moeritsen2/pypilot_obp/pics/IMG_2758.jpg

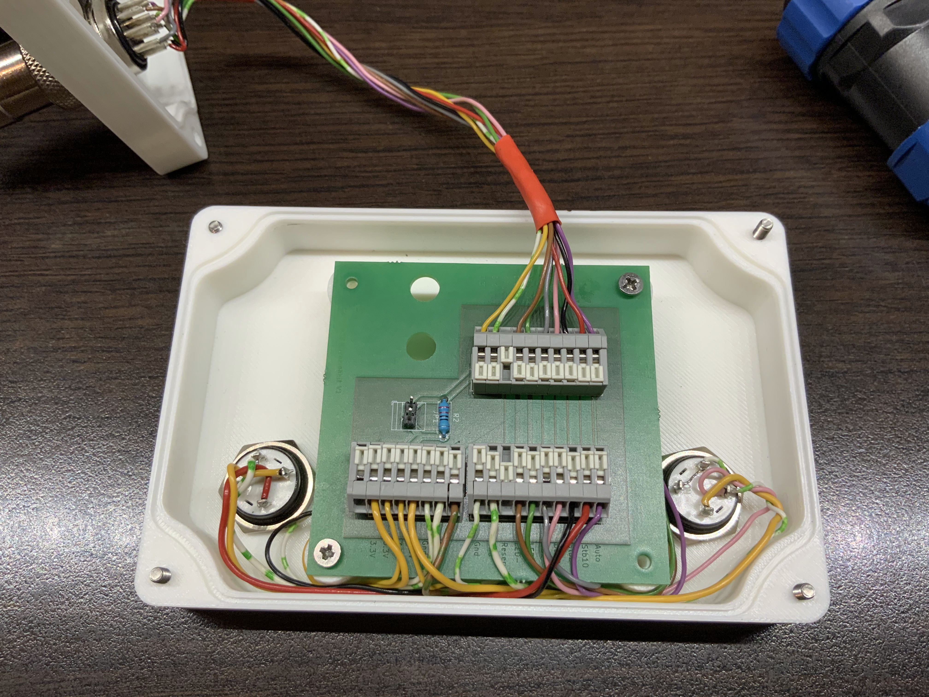
pics/IMG_2758.jpg
