moeritsen2/pypilot_obp/data/Übersicht Pypilot 2025.pdf

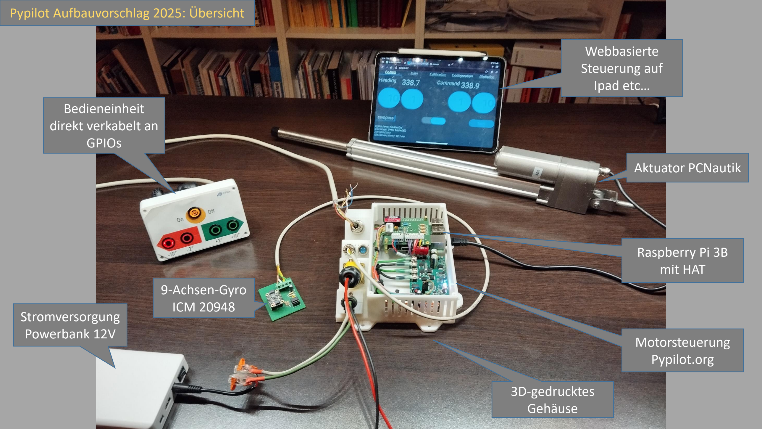
[picture p3: page 1]

Stromversorgung
Powerbank 12V

Bedieneinheit
direkt verkabelt an
GPIOs

9-Achsen-Gyro
ICM 20948

Motorsteuerung
Pypilot.org

Raspberry Pi 3B
mit HAT

Aktuator PCNautik

Webbasierte
Steuerung auf
Ipad etc…

3D-gedrucktes
Gehäuse

Pypilot Aufbauvorschlag 2025: Übersicht

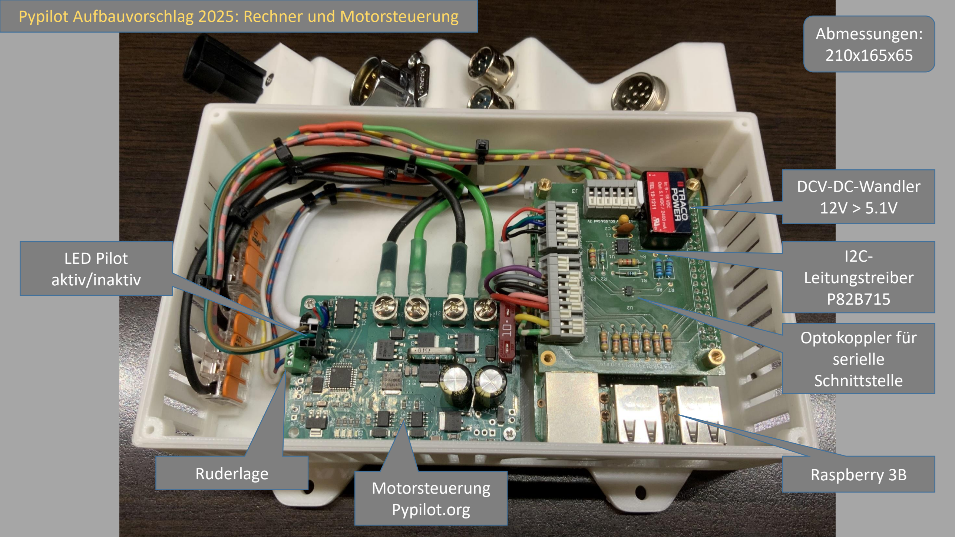
[picture p4: page 2]

Motorsteuerung
Pypilot.org

Ruderlage

DCV-DC-Wandler
12V > 5.1V

LED Pilot
aktiv/inaktiv

I2C-Leitungstreiber
P82B715

Optokoppler für
serielle
Schnittstelle

Raspberry 3B

Pypilot Aufbauvorschlag 2025: Rechner und Motorsteuerung Abmessungen:
210x165x65

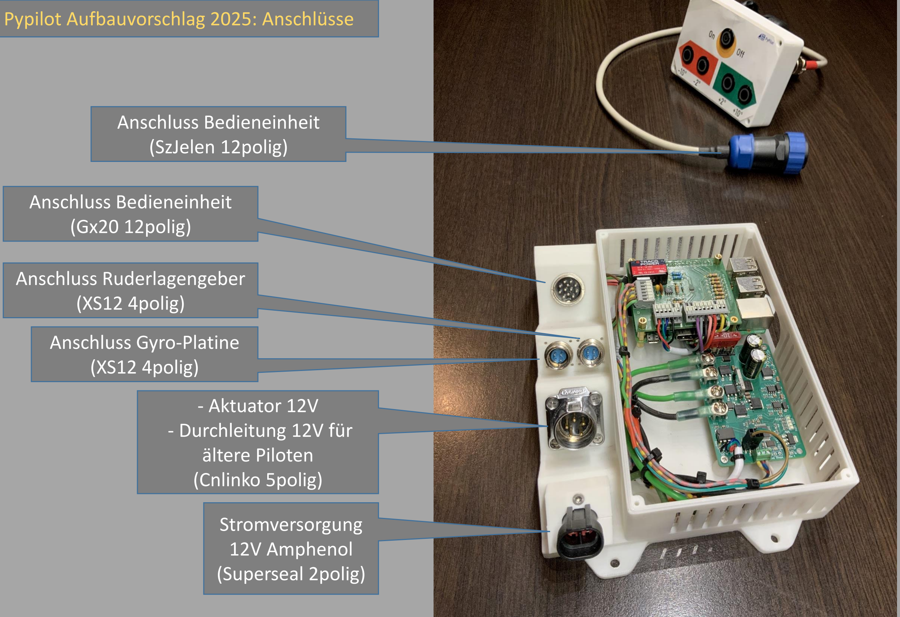
[picture p5: figure]
Pypilot Aufbauvorschlag 2025: Anschlüsse; Stromversorgung 12V Amphenol (Superseal 2polig); - Aktuator 12V - Durchleitung 12V für ältere Piloten (Cnlinko 5polig); Anschluss Gyro-Platine (XS12 4polig); Anschluss Ruderlagengeber (XS12 4polig); Anschluss Bedieneinheit (Gx20 12polig); Anschluss Bedieneinheit (SzJelen 12polig)
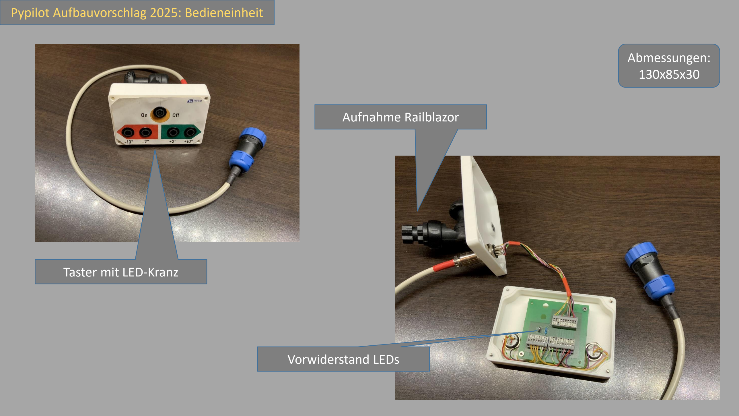
[picture p6: page 4]

Taster mit LED-Kranz

Aufnahme Railblazor

Vorwiderstand LEDs

Pypilot Aufbauvorschlag 2025: Bedieneinheit

Abmessungen:
130x85x30
