moeritsen2/pypilot_obp/AndroidASOP_DL.pdf

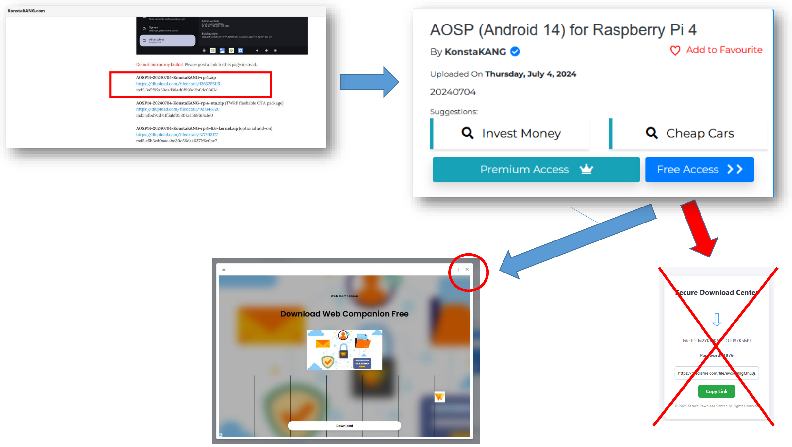
[picture p7: page 1]
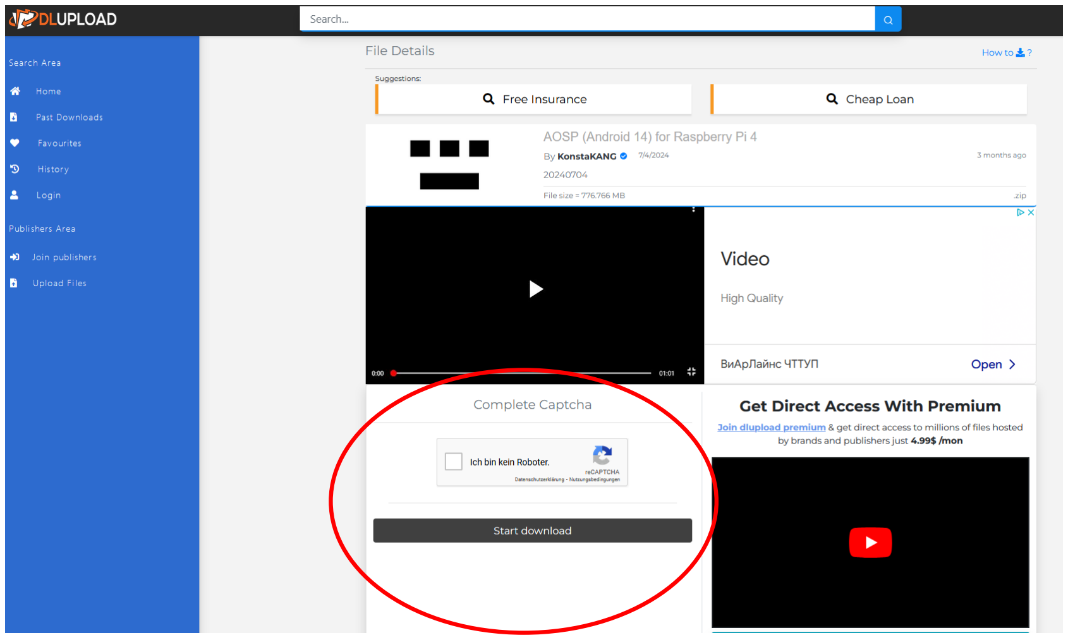
[picture p8: page 2]
