moeritsen2/pypilot_obp/boards/PlatineBedieneinheit.pdf

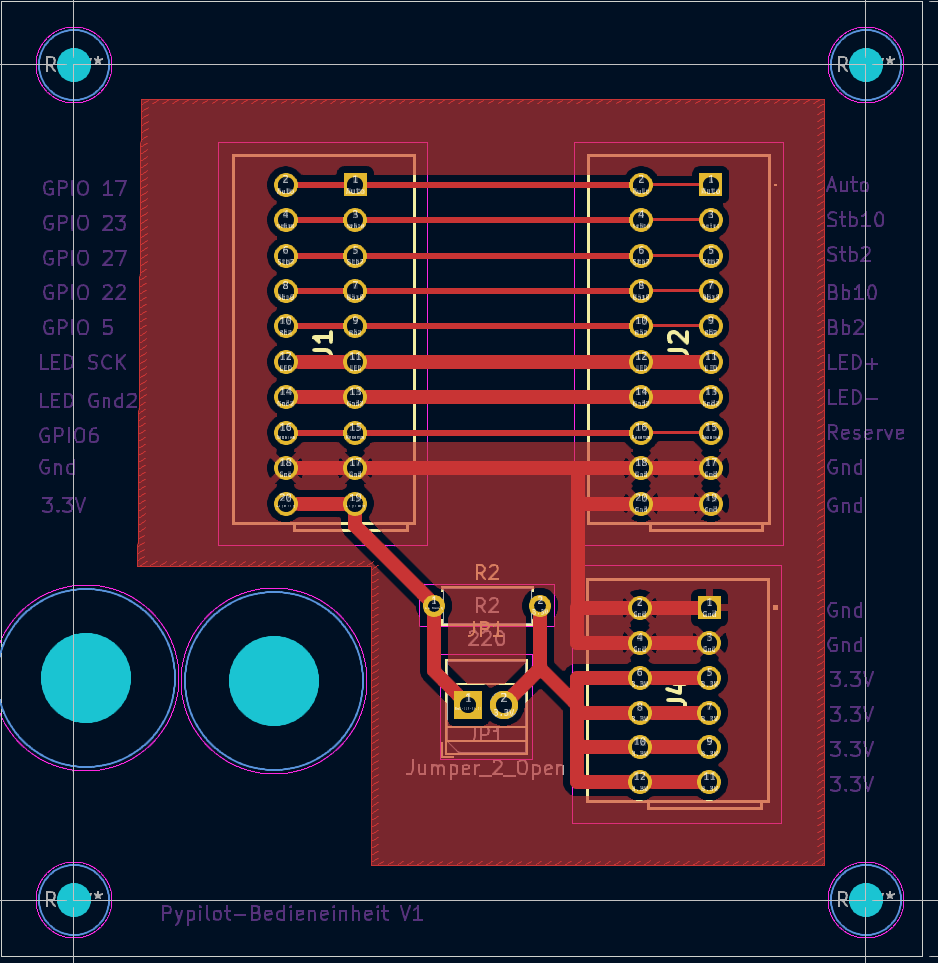
[picture p9: figure]
