moeritsen2/pypilot_obp/boards/PlatineHAT.pdf

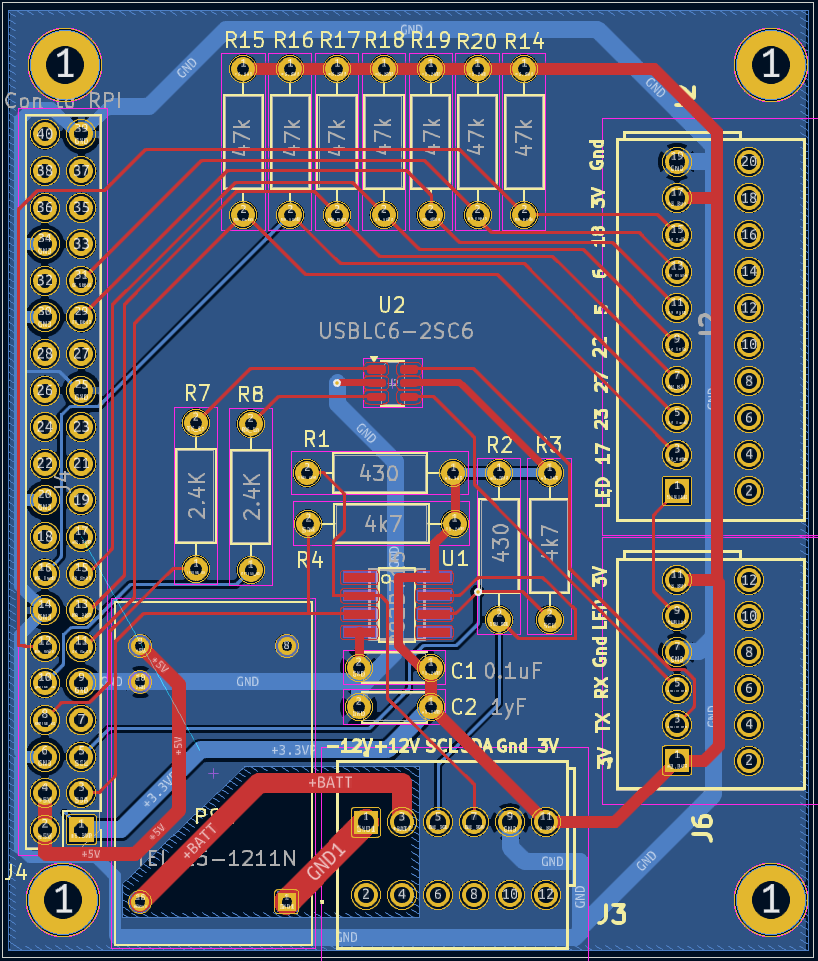
[picture p10: page 1]
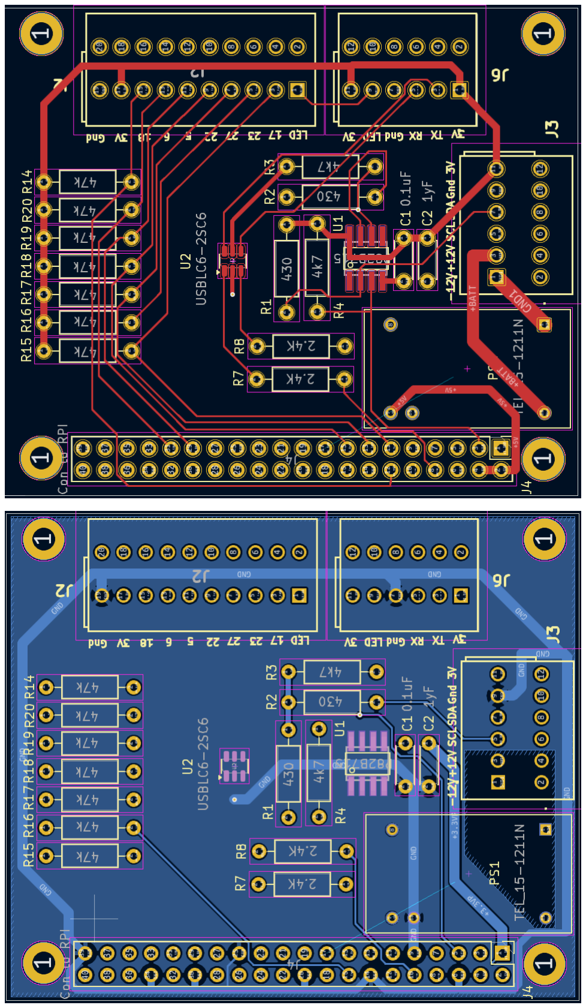
[picture p11: page 2]
