moeritsen2/pypilot_obp/boards/Schaltplan_Bedieneinheit.pdf

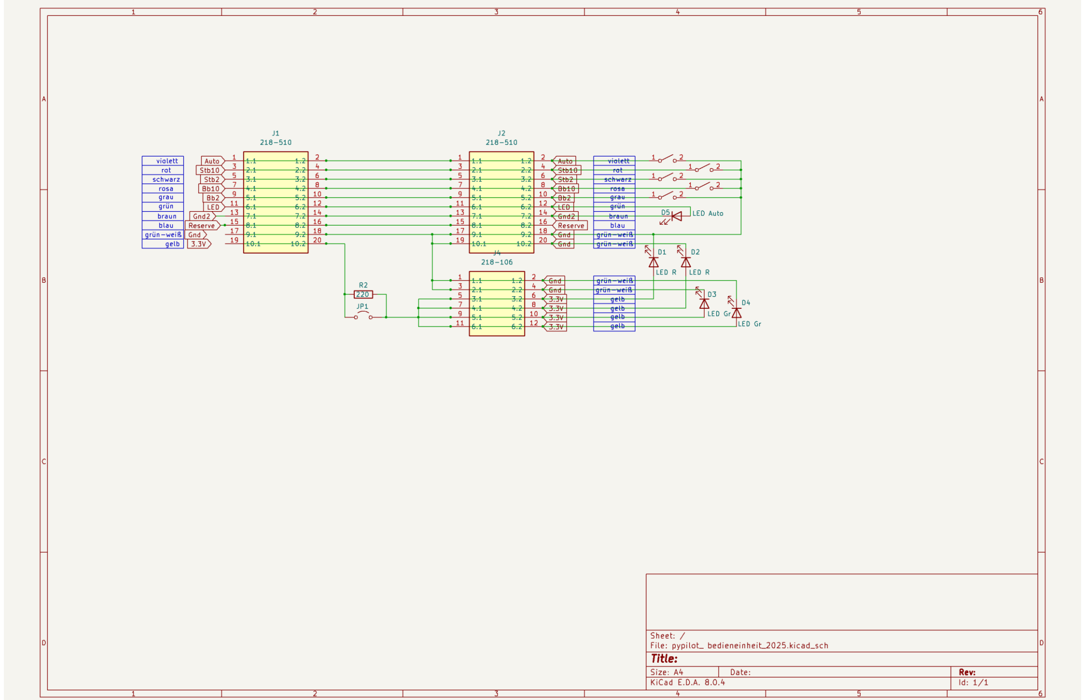
[picture p12: page 1]
