moeritsen2/pypilot_obp/boards/schaltplan_hat.pdf

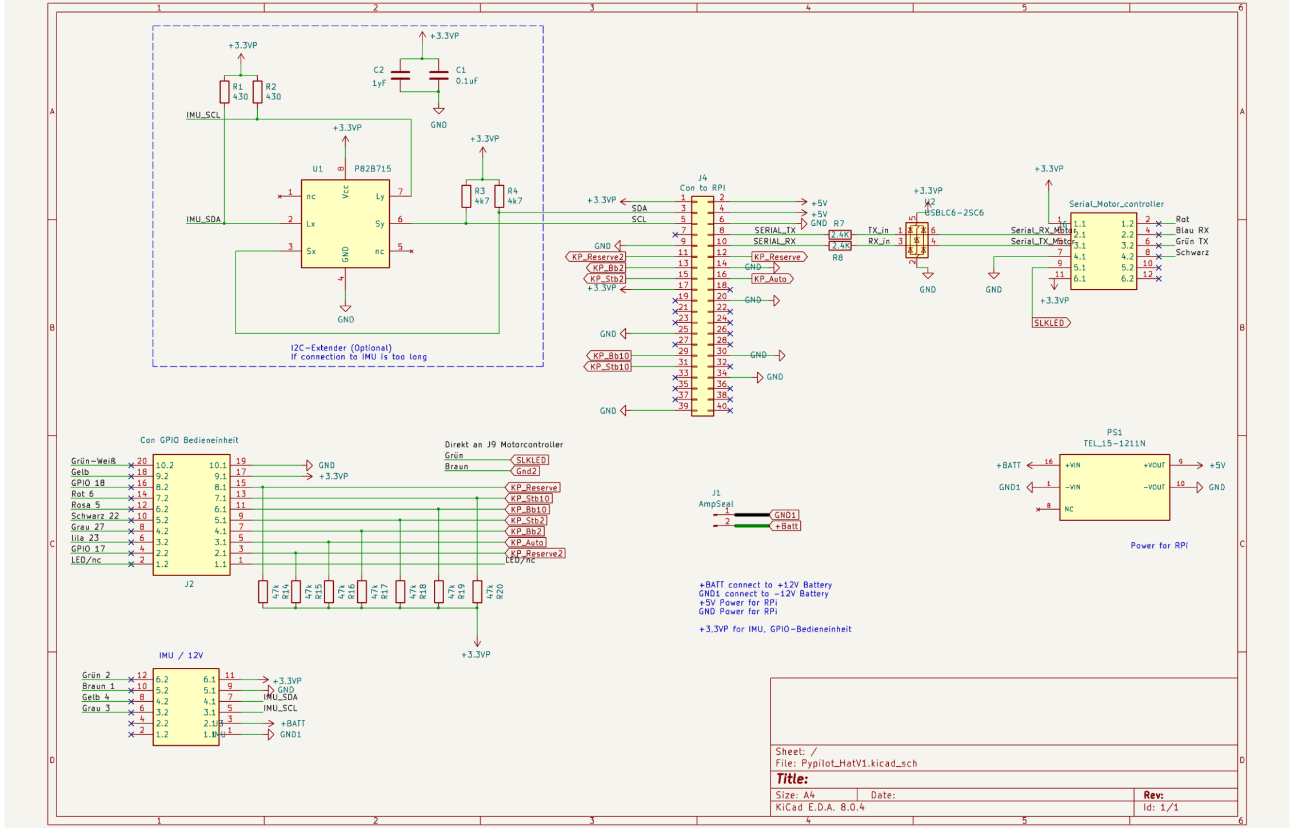
[picture p13: page 1]
