moeritsen2/pypilot_obp/pics/Bedieneinheit1.jpg

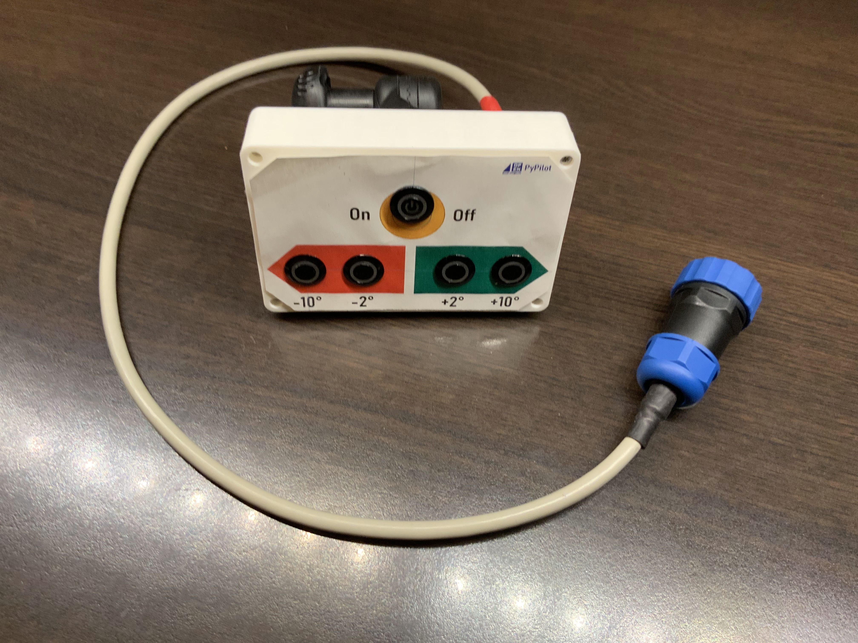
pics/Bedieneinheit1.jpg
