moeritsen2/pypilot_obp/pics/Gyro1.jpg

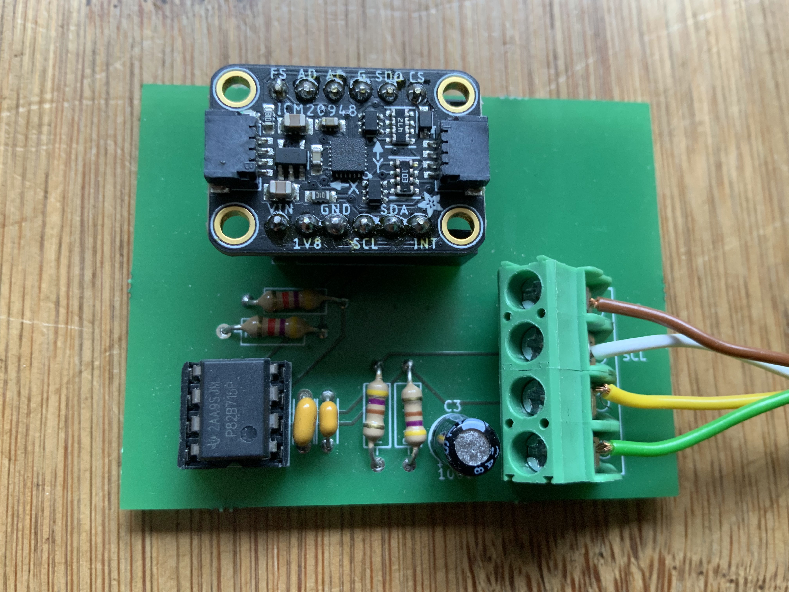
pics/Gyro1.jpg
