moeritsen2/pypilot_obp/pics/Gyro2.jpg

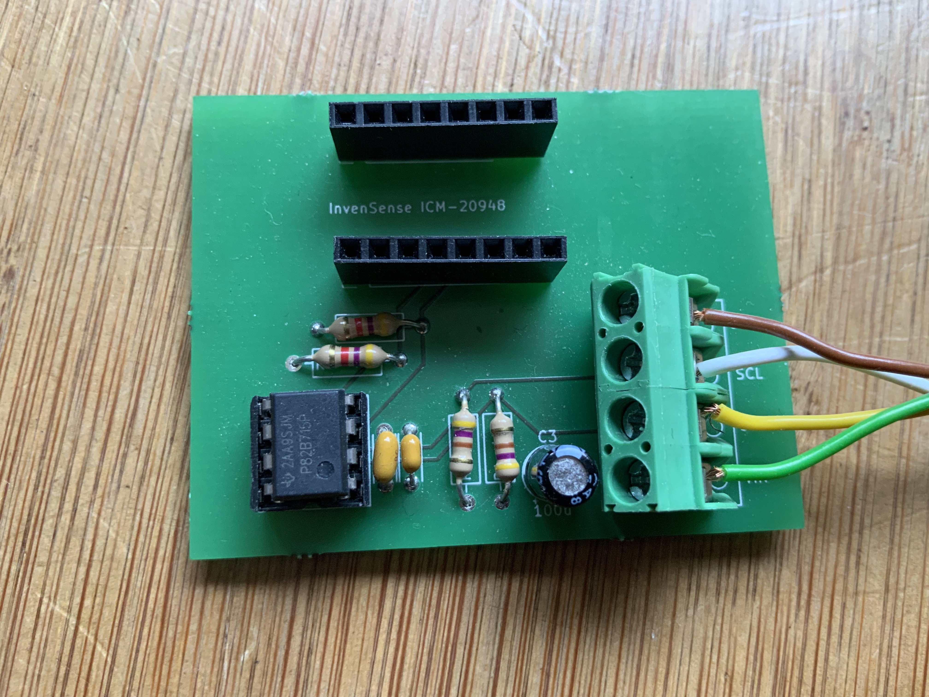
pics/Gyro2.jpg
