moeritsen2/pypilot_obp/pics/HAT-Platine1.jpg

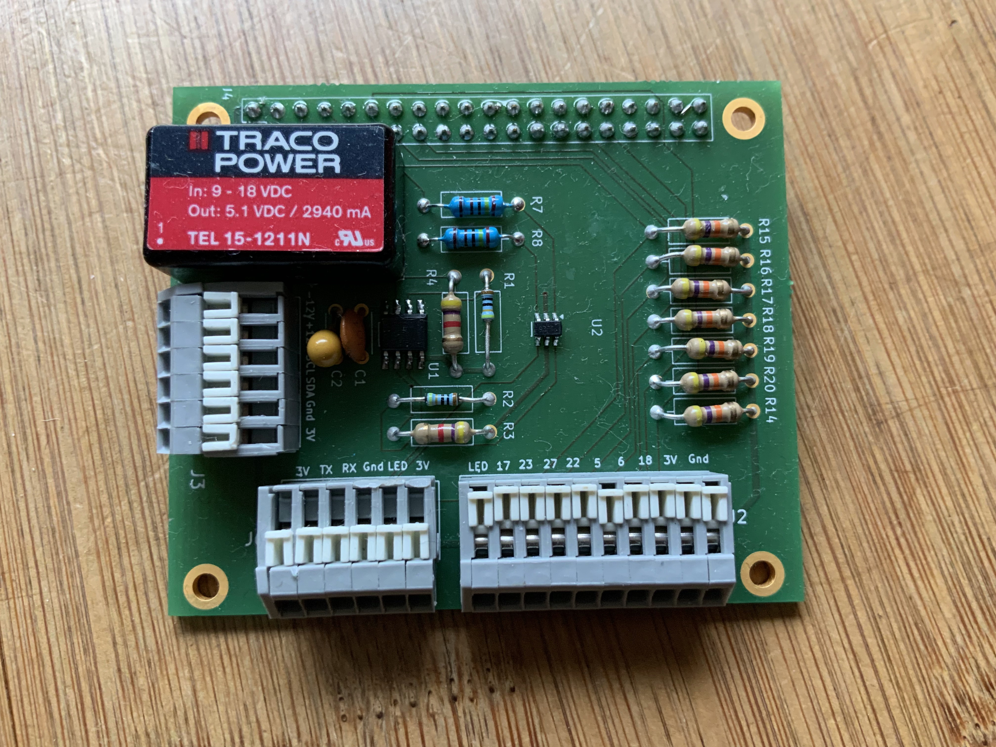
pics/HAT-Platine1.jpg
