moeritsen2/pypilot_obp/pics/IMG_2757.jpg

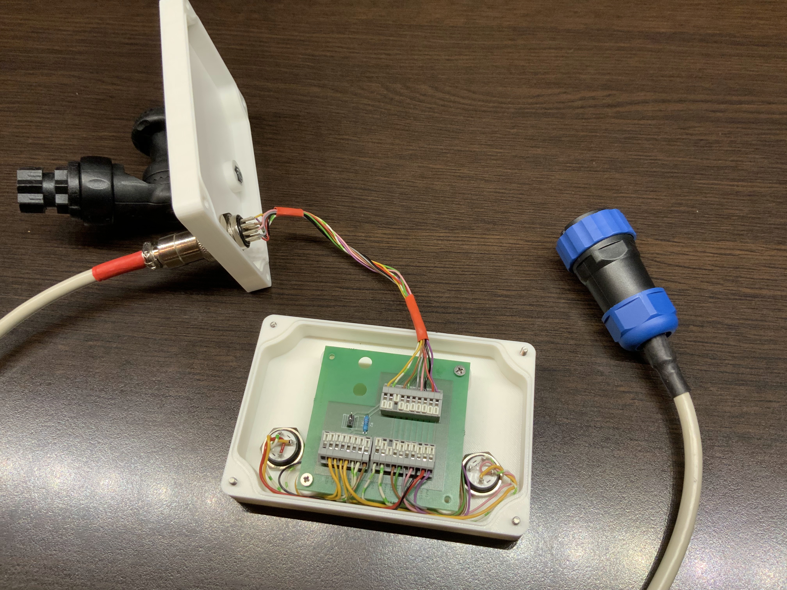
pics/IMG_2757.jpg
