moeritsen2/pypilot_obp/pics/IMG_2760.jpg

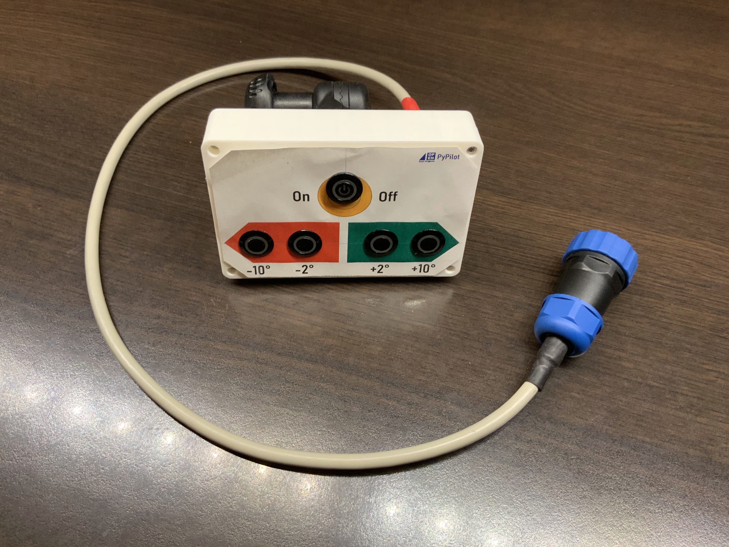
pics/IMG_2760.jpg
