moeritsen2/pypilot_obp/pics/IMG_2762.jpg

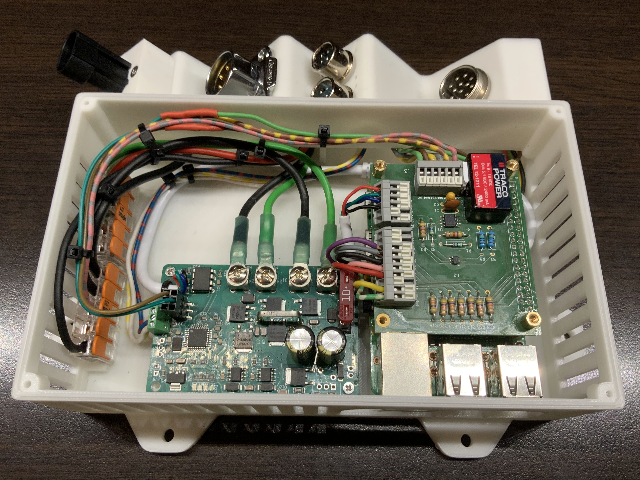
pics/IMG_2762.jpg
