moeritsen2/pypilot_obp/pics/IMG_2916.jpg

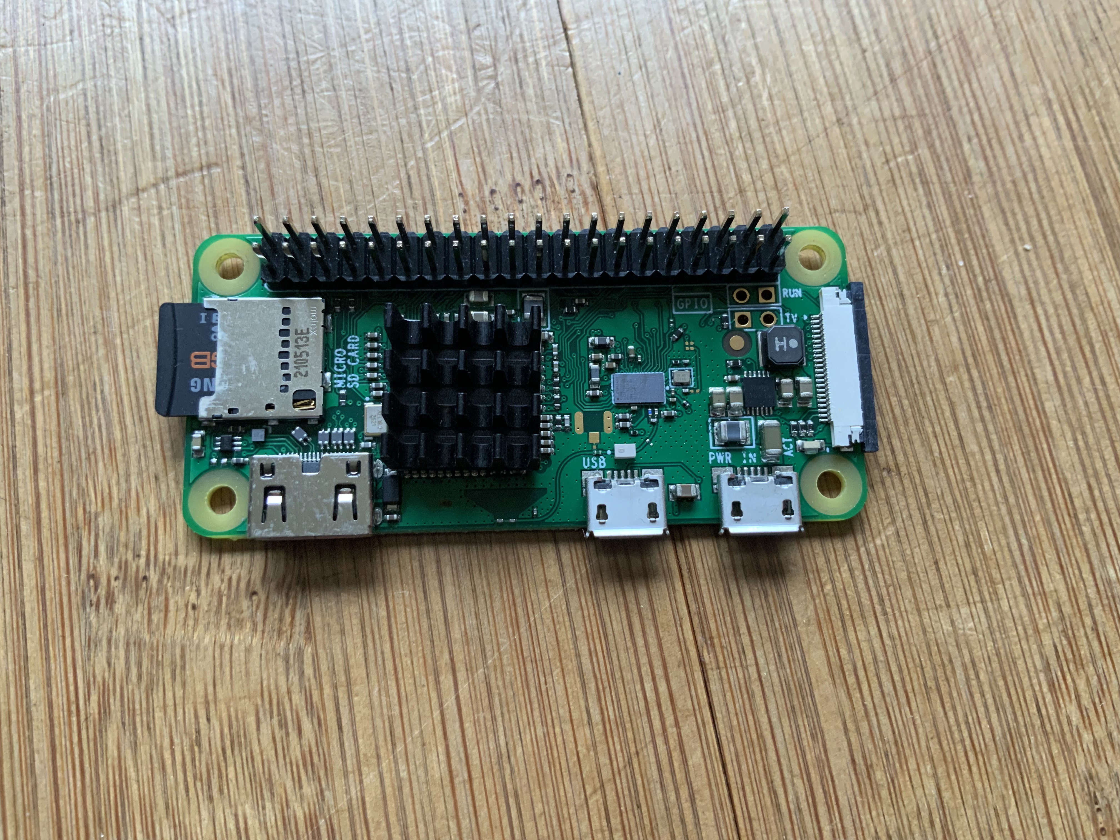
pics/IMG_2916.jpg
