moeritsen2/pypilot_obp/pics/IMG_2917.jpg

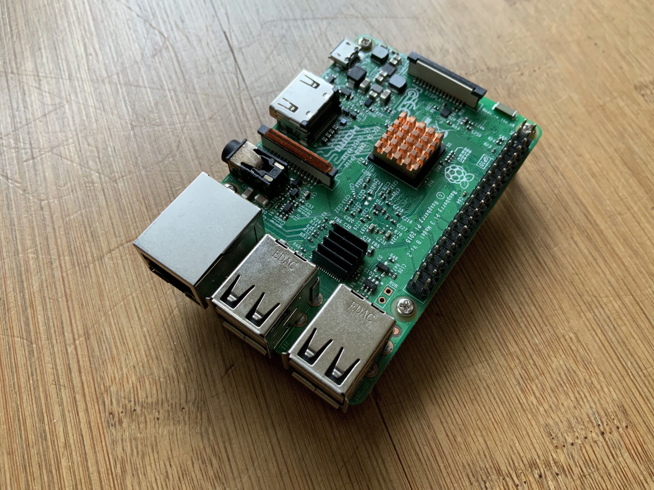
pics/IMG_2917.jpg
