moeritsen2/pypilot_obp/pics/IMG_2921.jpg

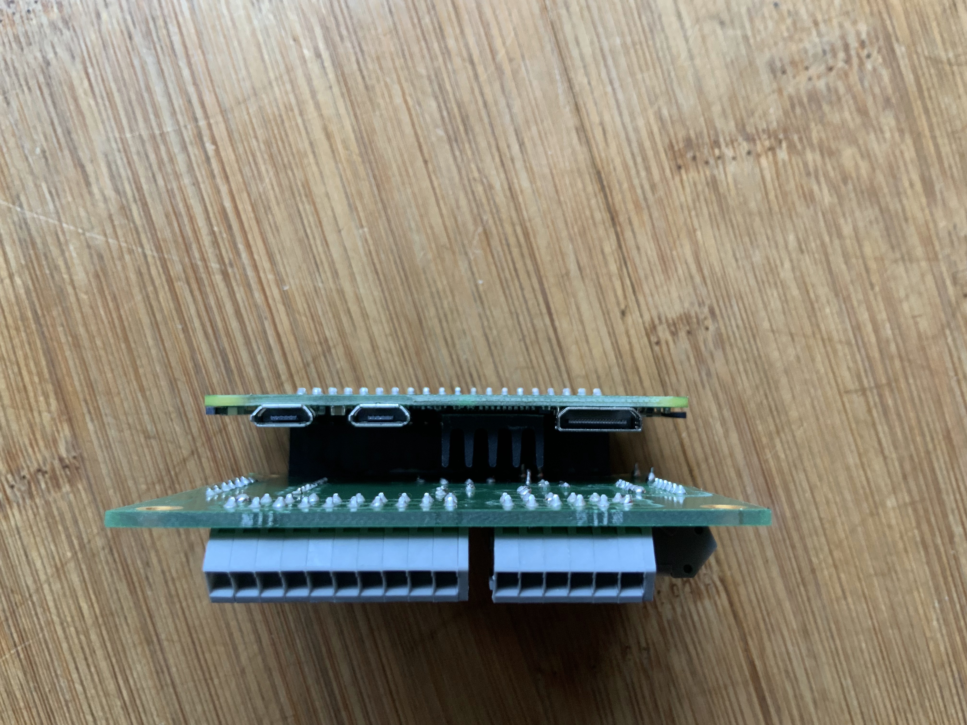
pics/IMG_2921.jpg
