moeritsen2/pypilot_obp/pics/IMG_2923.jpg

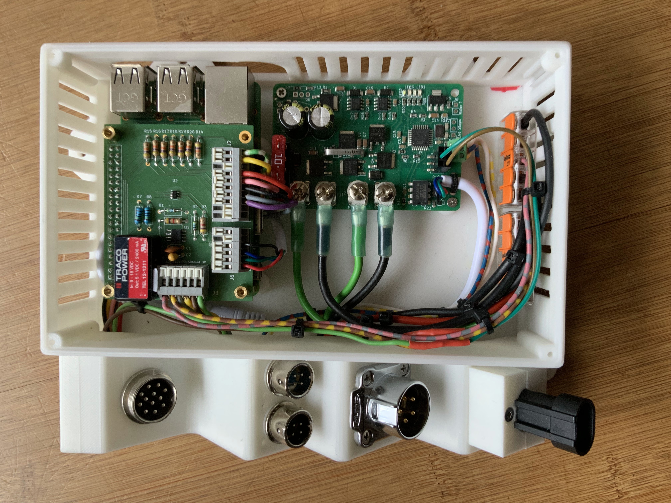
pics/IMG_2923.jpg
