moeritsen2/pypilot_obp/pics/Motorsteuerung PP2.jpg

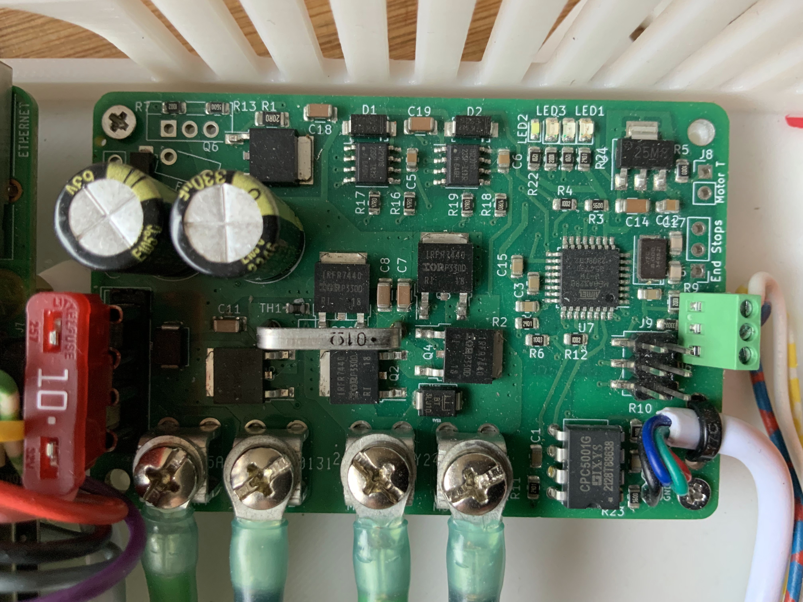
pics/Motorsteuerung PP2.jpg
