moeritsen2/pypilot_obp/pics/Motorsteuerung PP.jpg

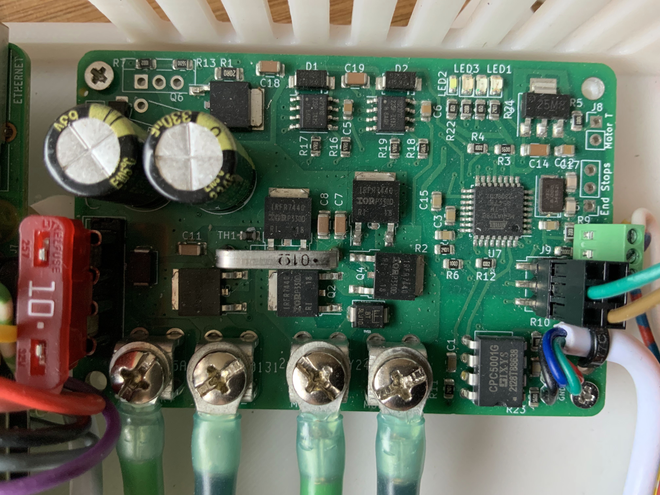
pics/Motorsteuerung PP.jpg
