moeritsen2/pypilot_obp/pics/Pypilot_HatV1.jpg

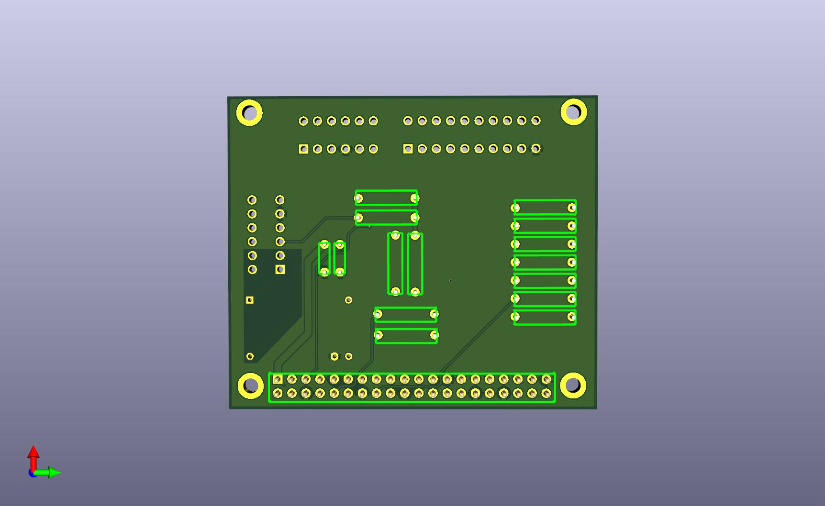
pics/Pypilot_HatV1.jpg
