moeritsen2/pypilot_obp/pics/Übersicht Pypilot 2025/Gehaeuse Buchsen bezeichnet.PNG

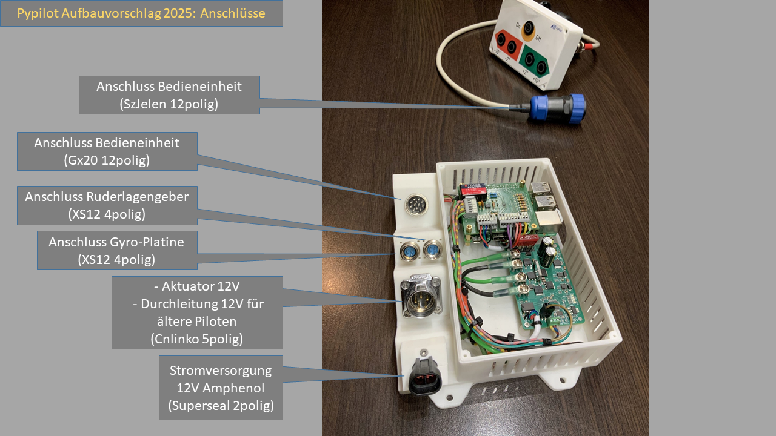
pics/Übersicht Pypilot 2025/Gehaeuse Buchsen bezeichnet.PNG
