moeritsen2/pypilot_obp/data/PyPilot_Gehäuse2024 v9.step

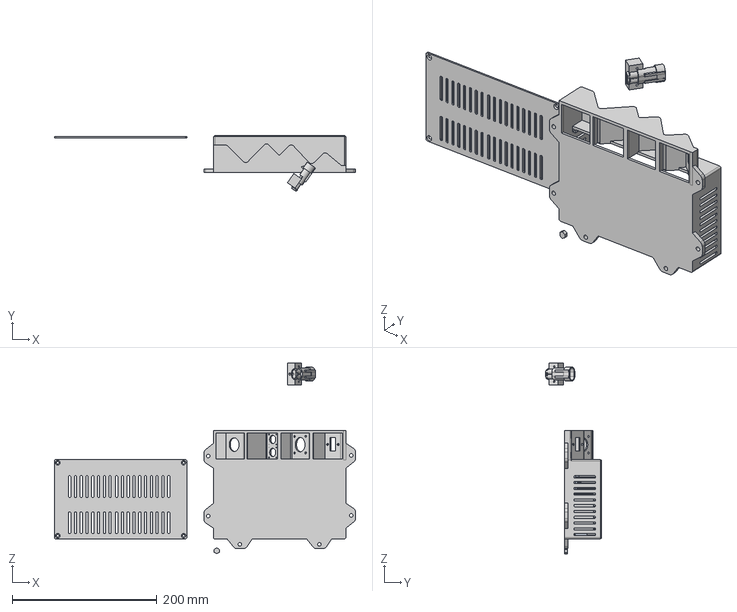
[picture p31: CAD file, 2025-02-05]
data/PyPilot_Gehäuse2024 v9.step
416.4 x 77.0 x 263.5 mm
Komponente1
17c1660_282104-1
