moeritsen2/pypilot_obp/(list of files, cad)

Other CAD files:
data/PyPilot_Gehäuse2024 v8.f3z
