moeritsen2/pypilot_obp/data/Frontplatte Bedieneinheit Taster V2025.pdf

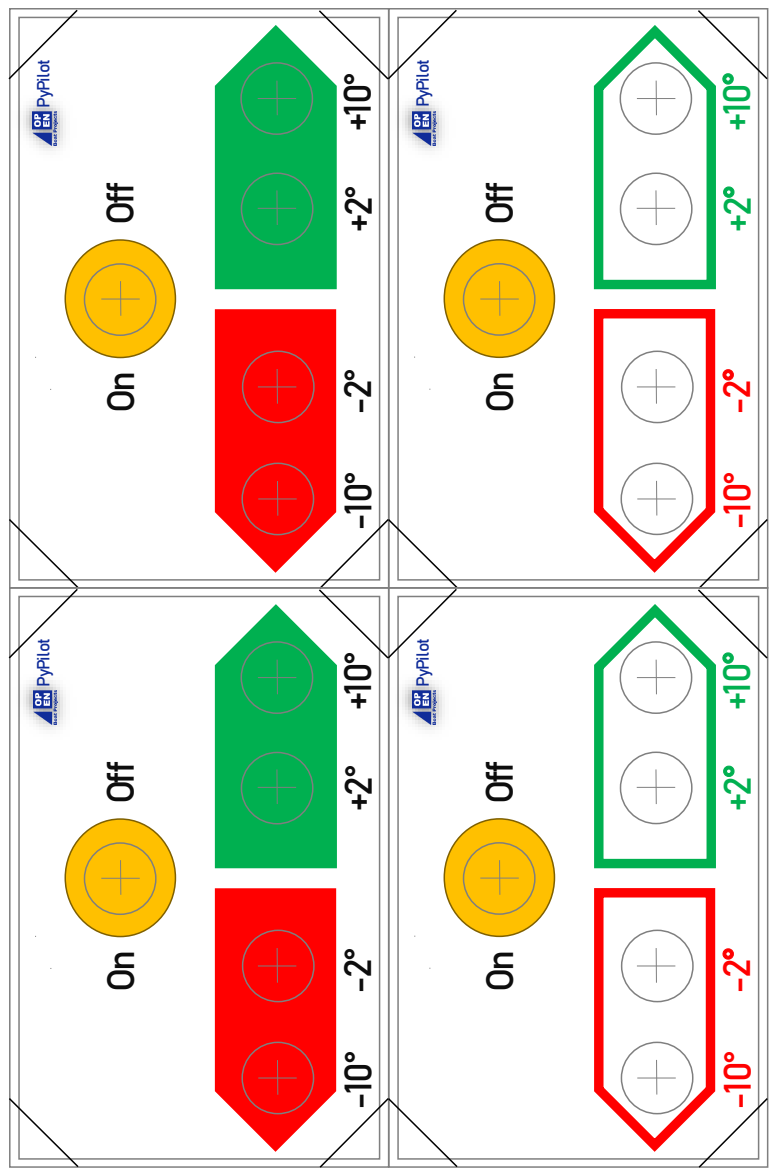
[picture p32: page 1]
Off; PyPilot

On -10° +10° -2° +2° Off PyPilot On -10° +10° -2° +2° Off

On -10° +10° -2° +2° Off PyPilot On

# Tack

Select | Menü

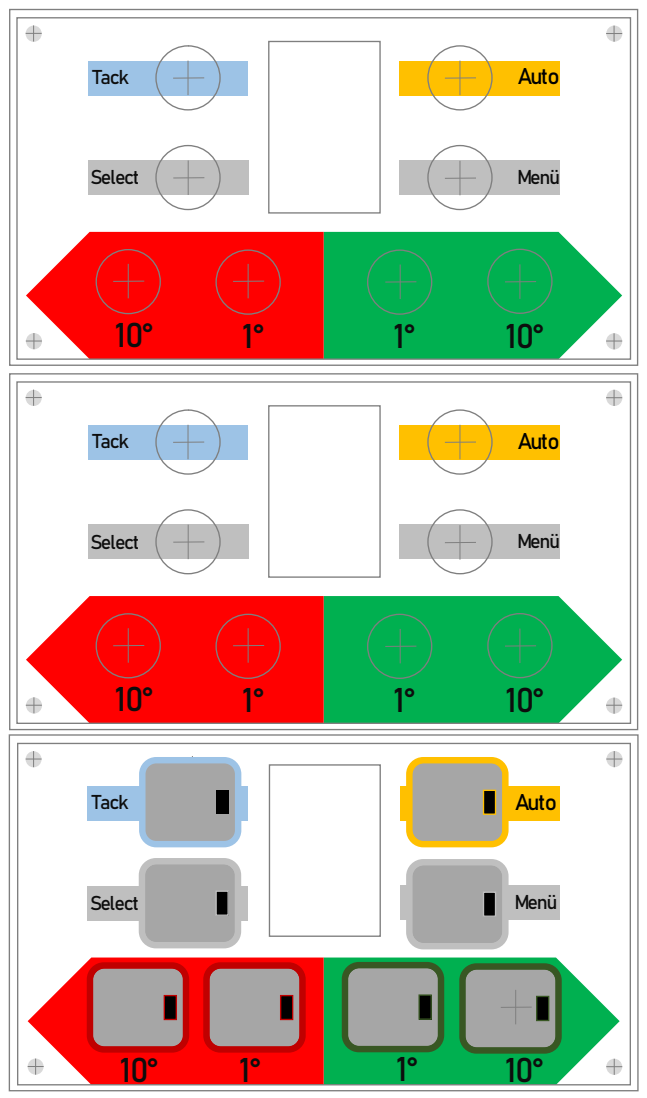
[picture p33: page 2]
Auto; Tack; Select; Menü

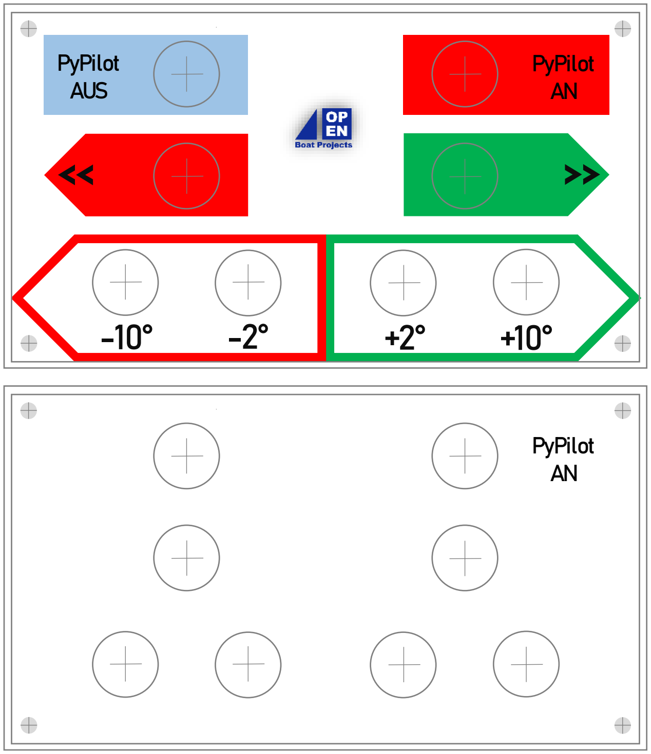
[picture p34: figure]
PyPilot AN; PyPilot AUS
