moeritsen2/pypilot_obp/boards/Pypilot_HatV1.kicad_pcb

## KiCad design boards/Pypilot_HatV1.kicad_pcb (2025-02-04)

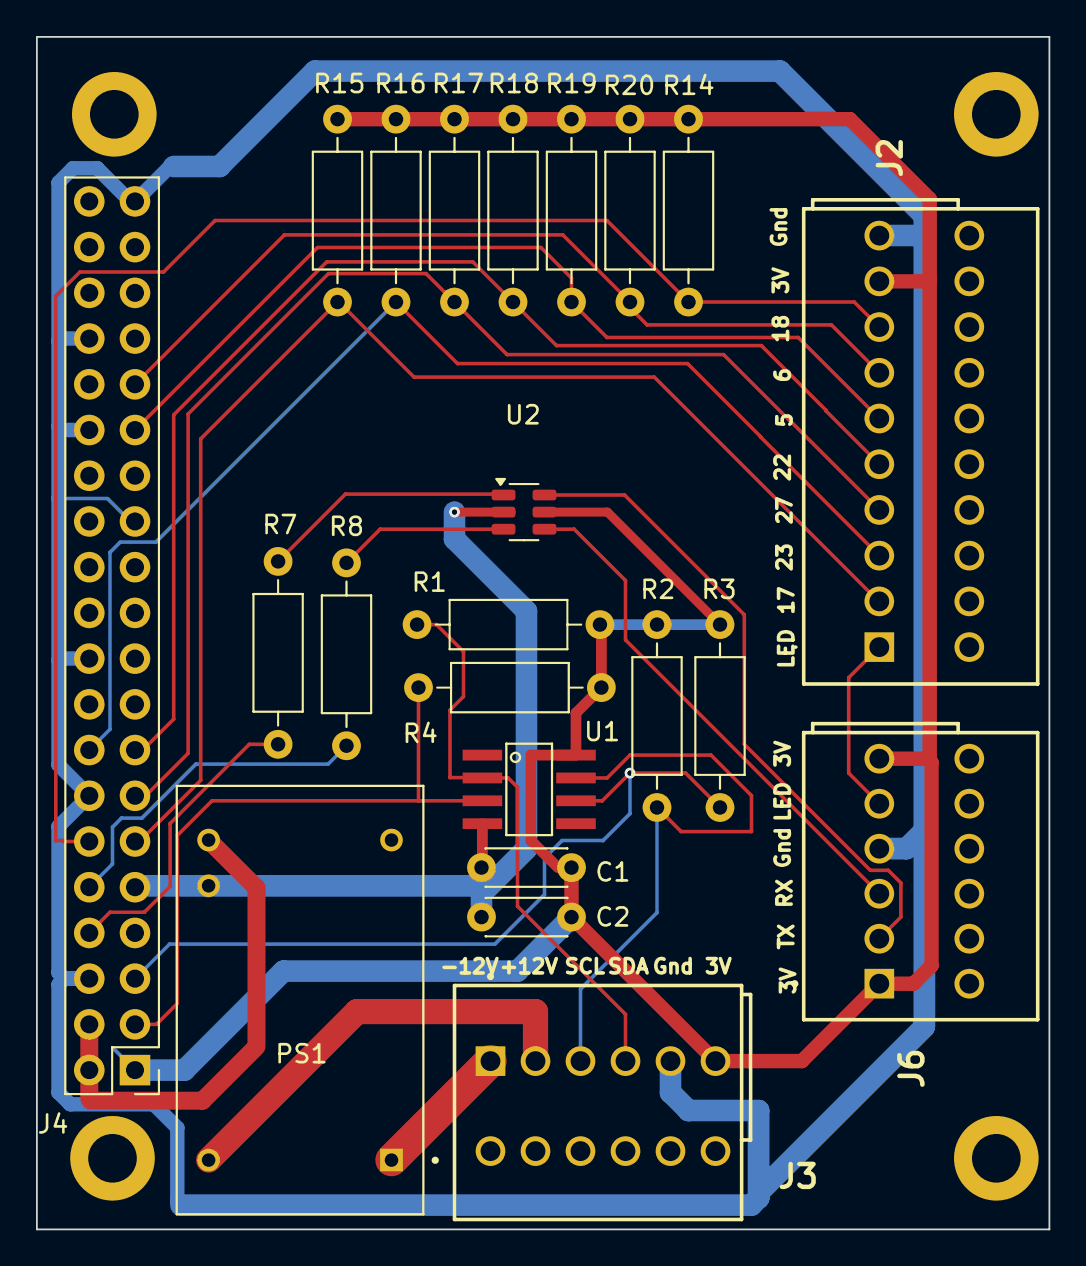
[picture p35: board Pypilot_HatV1.kicad_pcb from above]

Board: 2 copper layers, 56.2 x 66.2 mm, 22 parts (0 on the bottom side), 23 nets.

Parts:
C1: 0.1uF; C_Disc_D4.3mm_W1.9mm_P5.00mm
C2: 1yF; C_Disc_D4.3mm_W1.9mm_P5.00mm
J2: Con Bedien2; 218510
J3: IMU; 218106
J4: Con to RPI; PinHeader_2x20_P2.54mm_Vertical
J6: Serial_Motor_controller; 218106
PS1: TEL_15-1211N; CONV_TEL_15-1211N
R1, R2: 430; R_Axial_DIN0207_L6.3mm_D2.5mm_P10.16mm_Horizontal
R3, R4: 4k7; R_Axial_DIN0207_L6.3mm_D2.5mm_P10.16mm_Horizontal
R7, R8: 2.4K; R_Axial_DIN0207_L6.3mm_D2.5mm_P10.16mm_Horizontal
R14, R15, R16, R17, R18, R19, R20: 47k; R_Axial_DIN0207_L6.3mm_D2.5mm_P10.16mm_Horizontal
U1: P82B715; SO8
U2: USBLC6-2SC6; SOT-23-6

Connections:
+3.3VP: C1.1, C2.1, J2.17 (9.1), J3.11 (6.1), J4.1, J4.17, J6.1 (1.1), J6.11 (6.1), R1.1, R2.1, R3.1, R4.1, R14.1, R15.1, R16.1, R17.1, R18.1, R19.1, R20.1, U1.8 (Vcc), U2.5 (VBUS)
+5V: J4.2, J4.4, PS1.9 (+VOUT)
+BATT: J3.3 (2.1), PS1.16 (+VIN)
/IMU_SCL: J3.5 (3.1), R2.2, U1.7 (Ly)
/IMU_SDA: J3.7 (4.1), R1.2, U1.2 (Lx)
/RX_in: R8.2, U2.3 (I/O2)
/SCL: J4.5, R3.2, U1.6 (Sy)
/SDA: J4.3, R4.2, U1.3 (Sx)
/SERIAL_RX: J4.10, R8.1
/SERIAL_TX: J4.8, R7.1
/Serial_RX_Motor: J6.3 (2.1), U2.6 (I/O1)
/Serial_TX_Motor: J6.5 (3.1), U2.4 (I/O2)
/TX_in: R7.2, U2.1 (I/O1)
GND: C1.2, C2.2, J2.19 (10.1), J3.9 (5.1), J4.6, J4.9, J4.14, J4.20, J4.25, J4.30, J4.34, J4.39, J6.7 (4.1), PS1.10 (-VOUT), U1.4 (GND), U2.2 (GND)
GND1: J3.1 (1.1), PS1.1 (-VIN)
KP_Auto: J2.3 (2.1), J4.11, R15.2
KP_Bb2: J2.7 (4.1), J4.13, R17.2
KP_Bb10: J2.11 (6.1), J4.29, R19.2
KP_Mode: J2.15 (8.1), J4.12, R14.2
KP_Stb2: J2.9 (5.1), J4.15, R18.2
KP_Stb10: J2.13 (7.1), J4.31, R20.2
KP_Tack: J2.5 (3.1), J4.16, R16.2
SLKLED: J2.1 (1.1), J6.9 (5.1)
