moeritsen2/pypilot_obp/boards/pypilot_ bedieneinheit_2025.kicad_pcb

## KiCad design boards/pypilot_ bedieneinheit_2025.kicad_pcb (2025-02-04)

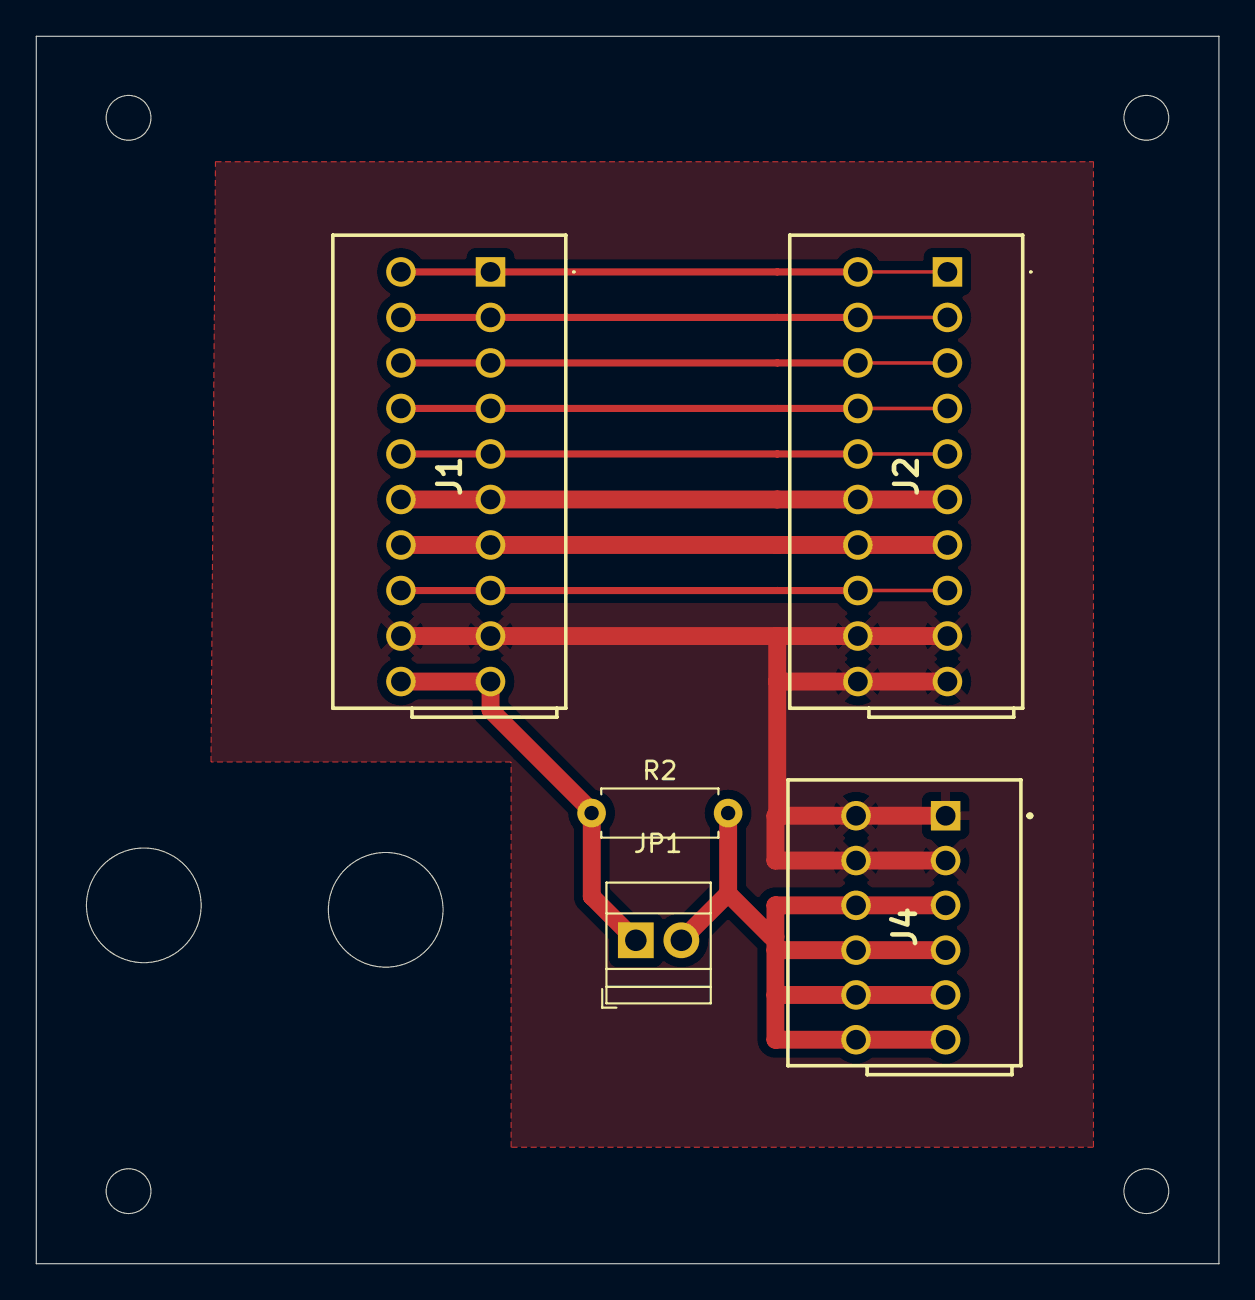
[picture p36: board pypilot_ bedieneinheit_2025.kicad_pcb from above]

Board: 2 copper layers, 66.0 x 68.5 mm, 5 parts (0 on the bottom side), 11 nets.

Parts:
J1, J2: 218-510; 218510
J4: 218-106; 218106
JP1: Jumper_2_Open; TerminalBlock_Xinya_XY308-2.54-2P_1x02_P2.54mm_Horizontal
R2: 220; R_Axial_DIN0207_L6.3mm_D2.5mm_P7.62mm_Horizontal

Connections:
3.3V: J4.5 (3.1), J4.6 (3.2), J4.7 (4.1), J4.8 (4.2), J4.9 (5.1), J4.10 (5.2), J4.11 (6.1), J4.12 (6.2), JP1.2 (B), R2.2
Auto: J1.1 (1.1), J1.2 (1.2), J2.1 (1.1), J2.2 (1.2)
Bb2: J1.9 (5.1), J1.10 (5.2), J2.9 (5.1), J2.10 (5.2)
Bb10: J1.7 (4.1), J1.8 (4.2), J2.7 (4.1), J2.8 (4.2)
Gnd: J1.17 (9.1), J1.18 (9.2), J2.17 (9.1), J2.18 (9.2), J2.19 (10.1), J2.20 (10.2), J4.1 (1.1), J4.2 (1.2), J4.3 (2.1), J4.4 (2.2)
Gnd2: J1.13 (7.1), J1.14 (7.2), J2.13 (7.1), J2.14 (7.2)
LED: J1.11 (6.1), J1.12 (6.2), J2.11 (6.1), J2.12 (6.2)
unnamed: J1.19 (10.1), J1.20 (10.2), JP1.1 (A), R2.1
Reserve: J1.15 (8.1), J1.16 (8.2), J2.15 (8.1), J2.16 (8.2)
Stb2: J1.5 (3.1), J1.6 (3.2), J2.5 (3.1), J2.6 (3.2)
Stb10: J1.3 (2.1), J1.4 (2.2), J2.3 (2.1), J2.4 (2.2)
