moeritsen2/pypilot_obp/pics/IMG_2763.jpg

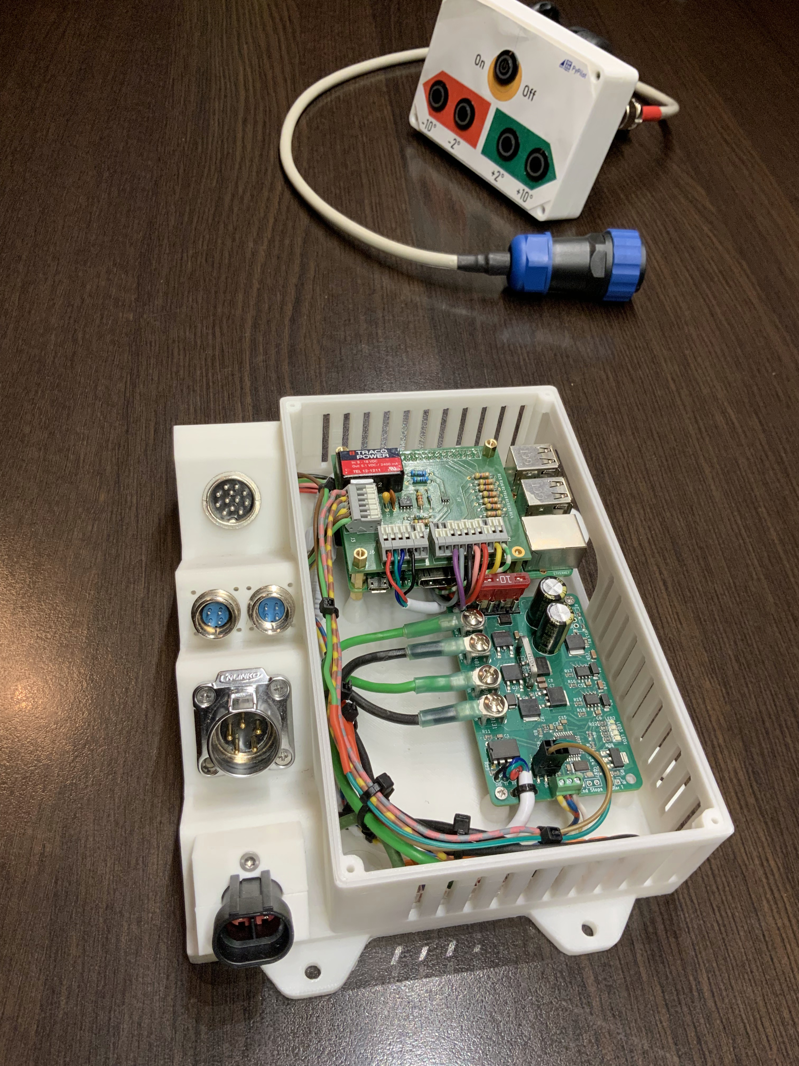
pics/IMG_2763.jpg
