moeritsen2/pypilot_obp/pics/IMG_2764.jpg

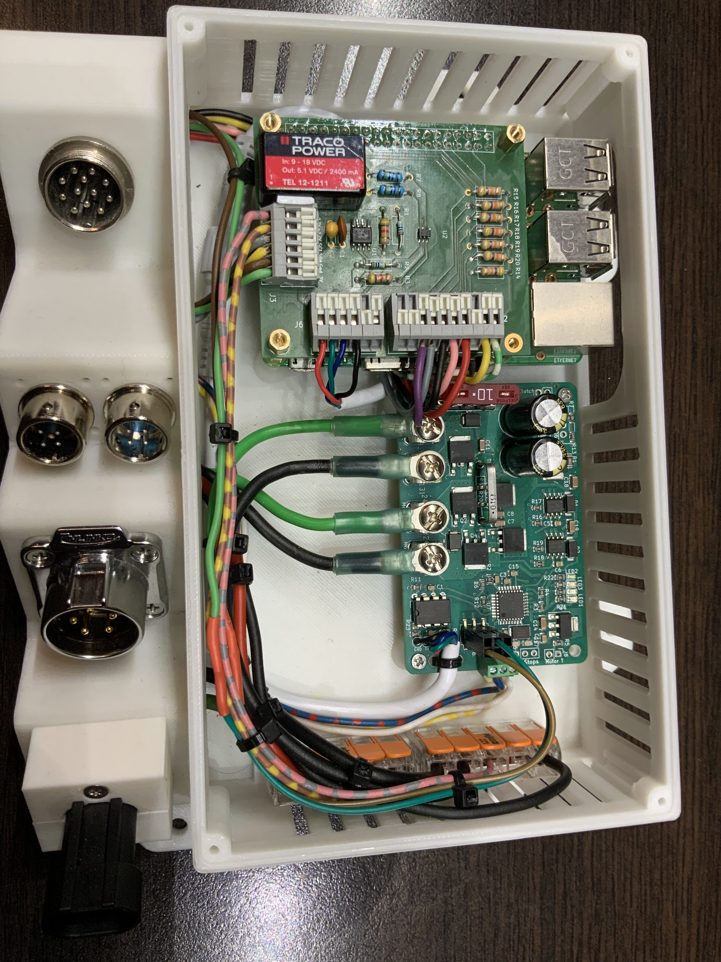
pics/IMG_2764.jpg
